aroutio/prop-hop-project/CAD/Test Stand V2.1/Test Stand Assembly.SLDASM

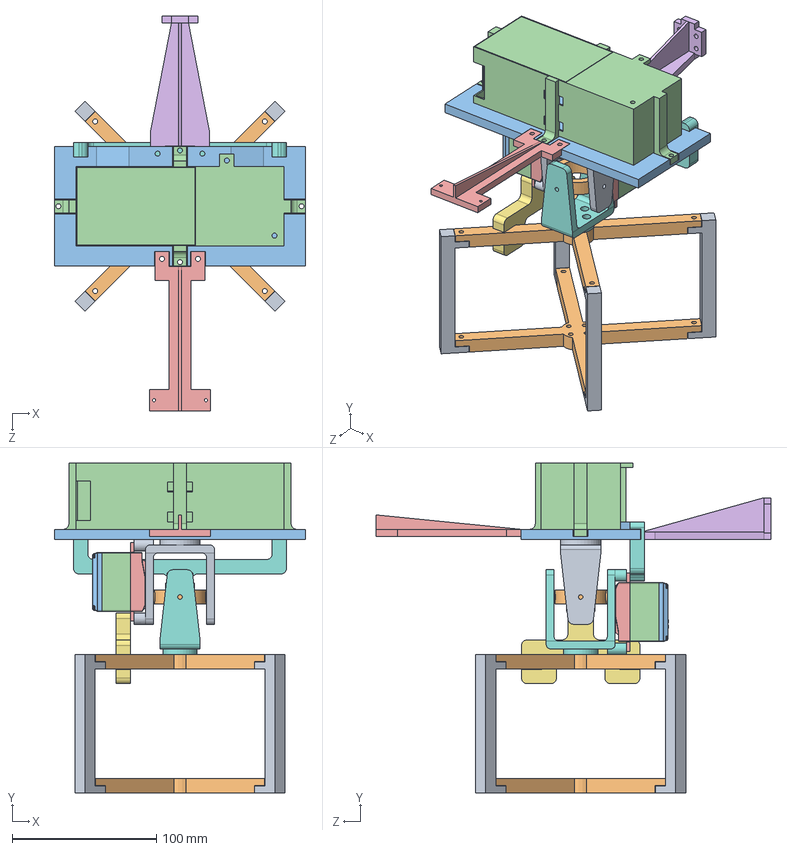
[picture p1: CAD file, 2025-03-03]
CAD/Test Stand V2.1/Test Stand Assembly.SLDASM
174.2 x 228.9 x 274.0 mm
Gimbal Mount Upper
Gimbal Ring
Tap 01 x 2
Tap 02 x 2
Tap 03 x 2
Eje x 2
pan head cross recess screw_iso x 8
Gimbal Mount Lower
Motor Mount Sides x 4
Motor Mount Upper-Lower x 2
Bottom Deck
Upper Deck
LIDAR Sensor Mount
Slider Mount
Upper Gimbal Lock
Lower Gimbal Lock
