aroutio/prop-hop-project/CAD/Test Stand V2.1/Gimbal Sub-Assembly.SLDASM

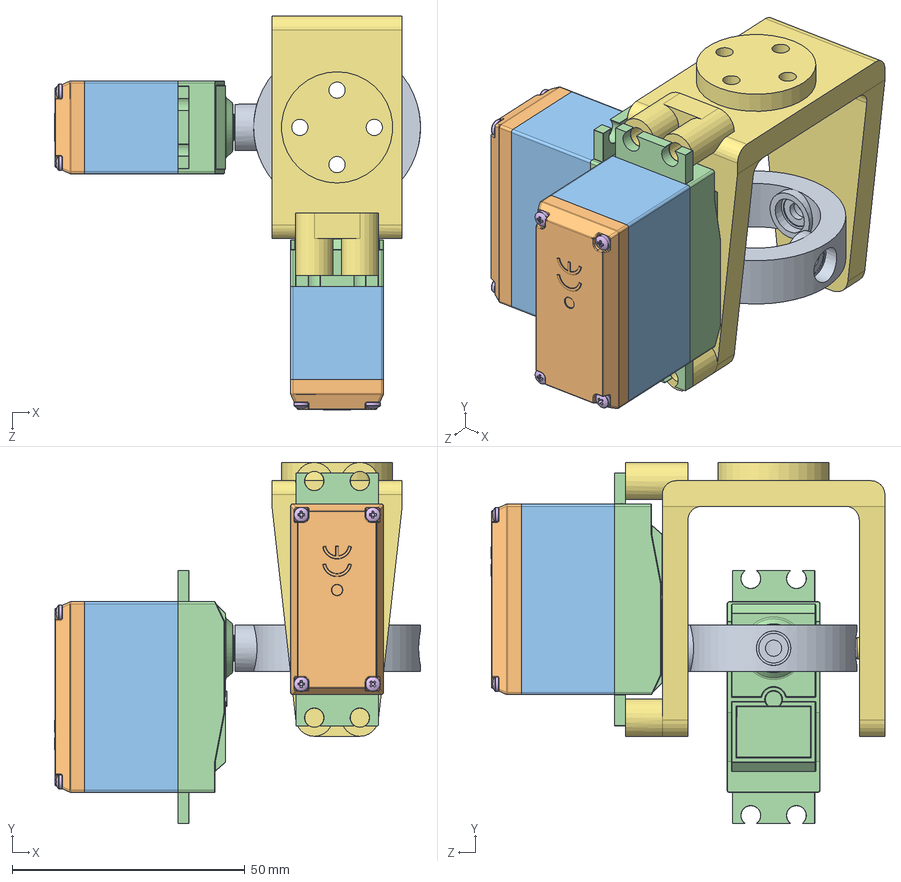
[picture p2: CAD file, 2025-02-25]
CAD/Test Stand V2.1/Gimbal Sub-Assembly.SLDASM
78.7 x 77.6 x 84.7 mm
Gimbal Ring
Tap 01 x 2
Tap 02 x 2
Tap 03 x 2
Eje x 2
pan head cross recess screw_iso x 8
Gimbal Mount Lower
