aroutio/prop-hop-project/CAD/Test Stand V2.1/Bottom Deck.SLDPRT

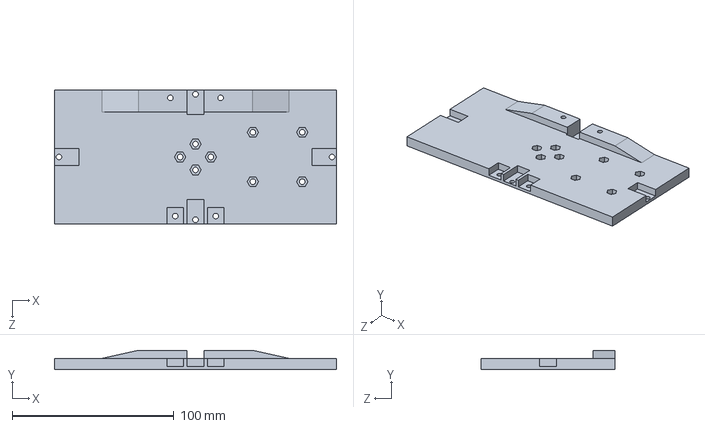
[picture p3: CAD file, 2025-03-03]
CAD/Test Stand V2.1/Bottom Deck.SLDPRT
174.2 x 12.0 x 83.0 mm
