aroutio/prop-hop-project/CAD/Test Stand V2.1/Upper Deck.sldprt

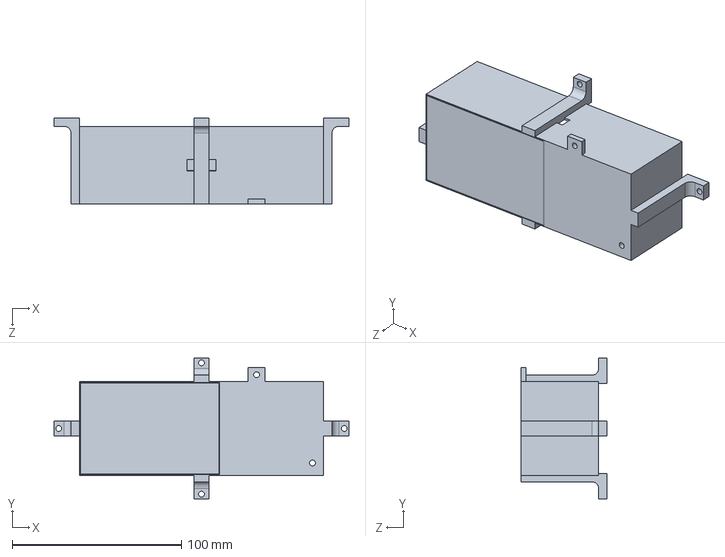
[picture p4: CAD file, 2025-03-03]
CAD/Test Stand V2.1/Upper Deck.sldprt
174.2 x 83.0 x 51.0 mm
