aroutio/prop-hop-project/CAD/Test Stand V2.1/Gimbal Ring.SLDPRT

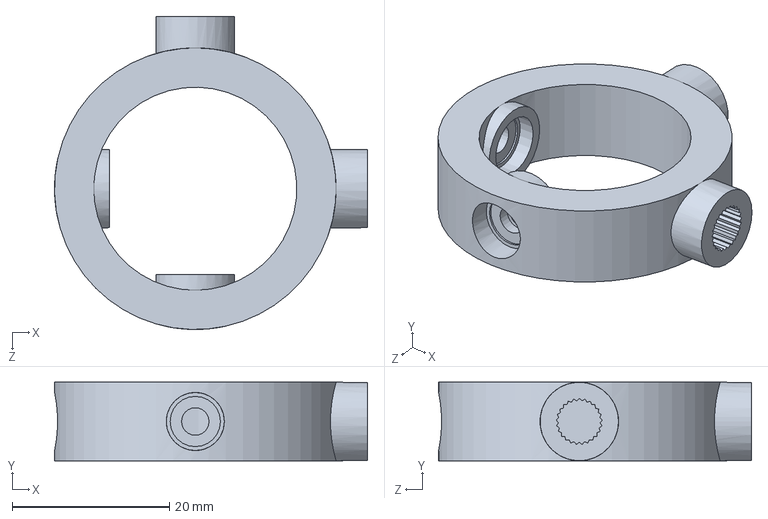
[picture p5: CAD file, 2025-02-25]
CAD/Test Stand V2.1/Gimbal Ring.SLDPRT
39.9 x 10.0 x 39.9 mm
