aroutio/prop-hop-project/CAD/Test Stand V2.1/Lower Gimbal Lock.SLDPRT

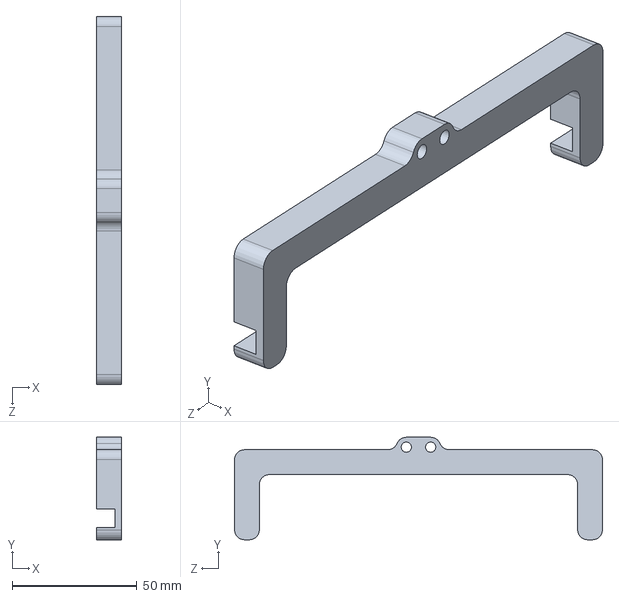
[picture p6: CAD file, 2025-02-25]
CAD/Test Stand V2.1/Lower Gimbal Lock.SLDPRT
10.0 x 41.2 x 147.8 mm
