aroutio/prop-hop-project/(list of files, cad)

Other CAD files:
CAD/Test Stand V2.1/Bottom Deck.STL
CAD/Test Stand V2.1/Gimbal Ring.STL
CAD/Test Stand V2.1/Lower Gimbal Lock.STL
CAD/Test Stand V2.1/Upper Deck.STL
