aroutio/prop-hop-project/CAD/Test Stand V2.1/vehicle_weight V2.xlsx

Cura Weight |  | Scale |  | Version 1.1
Component | Weight [g] | Component | Weight [g] | Structure | Weight [g] |  | Electronics | Weight [g]
Test Frame | 88 | Battery | 210 | Dist Sense Mount | 5 |  | Battery | 210
Second Frame | 27 | Dist Sense Mount | 5 | Test Frame | 76 |  | Dist Sense | 2
Landing Gear (2X) | 16 | Dist Sense | 2 | Second Frame | 26 |  | Prop and Motor | 68
Motor Mount | 4 | Prop and Motor | 68 | Slider | 105 |  | ESC | 31
Slider Mount (L) | 13 | Test Frame | 76 | Slider Mount (L) | 9 |  | Flight Computer | 22
Slider Mount (RR) | 13 | ESC | 31 | Slider Mount (RR) | 9 |  | Power Module | 25
Sense Mount | 5 | Flight Computer | 22 | Motor Mount | 61 |  | Wires | 10
Slider (3D Printed) | 20 | Power Module | 25 | Hardware (fastners) | 60 |  | Bread Board | 76
 |  | Wires | 8 |  |  |  | Y Power Connector | 31
Total | 186 | Hardware (fastners) | 60 | Total | 351 |  | Prop and Motor | 69
 |  | Second Frame | 26 |  |  |  | ESC | 31
 |  | Bread Board | 76 |  |  |  | Telemtry | 12
 |  | Slider | 105
 |  | Slider Mount (L) | 9
 |  | Slider Mount (RR) | 9 |  |  |  | Total | 587
 |  | Y Power Connector | 31
 |  | Prop and Motor | 69 | Total Total | 938
 |  | ESC | 31
 |  | Motor Mount | 61 | Version 2 Estimate
 |  |  |  | Structure | Weight [g] |  | Electronics | Weight [g]
 |  | Accel/Gyro | 3 | Dist Sense Mount | 5 |  | Battery | 210
 |  | Motor Mount | 4 | Test Frame | 76 |  | Dist Sense | 2
 |  | Landing Gear 1 | 8 | Second Frame | 26 |  | Prop and Motor | 68
 |  | Landing Gear 2 | 8 | ~~Slider ~~ | 0 |  | ESC | 31
 |  |  |  | ~~Slider Mount (L)~~ | 0 |  | Flight Computer | 22
 |  | Total | 924 | ~~Slider Mount (RR)~~ | 0 |  | Power Module | 25
 |  |  |  | Motor Mount | 61 |  | Wires | 10
 |  | Recorded |  | Hardware (fastners) | 60 |  | Bread Board | 38
 |  |  |  |  |  |  | Y Power Connector | 31
 |  |  |  | Total | 228 |  | Prop and Motor | 69
 |  | Updated Slider | 11 |  |  |  | ESC | 31
 |  | Each Wheel Assembly | 19 |  |  |  | Telemtry | 16
 |  |  |  |  |  |  | Servos | 78
 |  | New Slider Total | 68 |  |  |  | Accel/Gyro | 3
 |  |  |  |  |  |  | Total | 634
 |  |  |  | Total Total | 862
 |  |  |  | Version 2 (Hover Testing Config)
 |  |  |  | Structure | Weight [g] |  | Electronics | Weight [g]
 |  |  |  | LIDAR Sense Mount | 8 |  | Gimbal Servo 2x | 90
 |  |  |  | Bottom Deck | 36 |  | Battery | 210
 |  |  |  | Upper Deck | 23 |  | Lidar Sensor | 5
 |  |  |  | Motor Mount Upper/Lower 2x | 30 |  | Prop and Motor 2x | 136
 |  |  |  | Motor Mount Sides 2x | 14 |  | ESC 2x | 62
 |  |  |  | Gimble Mount 2x | 30 |  | Flight Computer | 22
 |  |  |  | Gimbal Ring | 4 |  | Power Module | 25
 |  |  |  | Gimbal Bearings 4x | 1 |  | Bread Board | 38
 |  |  |  | Slider Mount | 13 |  | Y Power Connector | 31
 |  |  |  | Slide | 16 |  | Radio | 12
 |  |  |  | Fasteners/Washers/Nuts | 41 |  | IMU | 3
 |  |  |  |  |  |  | Wires | 11
 |  |  |  | Total | 216
 |  |  |  |  |  |  | Total | 645
 |  |  |  | Total Vehicle | 861
 |  |  |  | Version 2 (Flight Config)
 |  |  |  | Structure | Weight [g] |  | Electronics | Weight [g]
 |  |  |  | LIDAR Sense Mount | 8 |  | Gimbal Servo 2x | 90
 |  |  |  | Bottom Deck | 36 |  | Battery | 210
 |  |  |  | Upper Deck | 23 |  | Lidar Sensor | 5
 |  |  |  | Motor Mount Upper/Lower 2x | 30 |  | Prop and Motor 2x | 136
 |  |  |  | Motor Mount Sides 2x | 14 |  | ESC 2x | 62
 |  |  |  | Gimble Mount 2x | 30 |  | Flight Computer | 22
 |  |  |  | Gimbal Ring | 4 |  | Power Module | 25
 |  |  |  | Gimbal Bearings 4x | 1 |  | Bread Board | 38
 |  |  |  | ~~Slider Mount~~ | 0 |  | Y Power Connector | 31
 |  |  |  | ~~Slide~~ | 0 |  | Radio | 12
 |  |  |  | Fasteners/Washers/Nuts | 38 |  | IMU | 3
 |  |  |  |  |  |  | Wires | 11
 |  |  |  | Total | 184
 |  |  |  |  |  |  | Total | 645
 |  |  |  | Total Vehicle | 829
 |  |  |  | Version 2.1 Estimate (Hover Testing Config)
 |  |  |  | Structure | Weight [g] |  | Electronics | Weight [g]
 |  |  |  | LIDAR Sense Mount | 8 |  | Gimbal Servo 2x | 90
 |  |  |  | Bottom Deck | 40 |  | Battery | 403
 |  |  |  | Upper Deck | 26 |  | Lidar Sensor | 5
 |  |  |  | Motor Mount Upper/Lower 2x | 34 |  | Prop and Motor 2x | 96
 |  |  |  | Motor Mount Sides 4x | 20 |  | ESC | 19
 |  |  |  | Gimble Mount 2x | 30 |  | Flight Computer | 22
 |  |  |  | Gimbal Ring | 4 |  | Power Module | 22
 |  |  |  | Gimbal Bearings 4x | 1 |  | Bread Board | 38
 |  |  |  | Slider Mount | 12 |  | ~~Y Power Connector~~ | 0
 |  |  |  | Slide | 16 |  | Radio | 12
 |  |  |  | Fasteners/Washers/Nuts | 42 | Needs Updating | IMU+MAG+Wires | 7
 |  |  |  |  |  |  | GPS | 8
 |  |  |  | Total | 233 |  | PWM Board | 9
 |  |  |  |  |  |  | Wires | 11 | Needs Updating
 |  |  |  |  |  |  | Total | 742
 |  |  |  | Total Vehicle | 975
 |  |  |  | Version 2.1 Estimate (Flight Config)
 |  |  |  | Structure | Weight [g] |  | Electronics | Weight [g]
 |  |  |  | LIDAR Sense Mount | 8 |  | Gimbal Servo 2x | 90
 |  |  |  | Bottom Deck | 40 |  | Battery | 403
 |  |  |  | Upper Deck | 26 |  | Lidar Sensor | 5
 |  |  |  | Motor Mount Upper/Lower 2x | 34 |  | Prop and Motor 2x | 94
 |  |  |  | Motor Mount Sides 2x | 20 |  | ESC | 19
 |  |  |  | Gimble Mount 2x | 30 |  | Flight Computer | 22
 |  |  |  | Gimbal Ring | 4 |  | Power Module | 22
 |  |  |  | Gimbal Bearings 4x | 1 |  | Bread Board | 38
 |  |  |  | ~~Slider Mount~~ | 0 |  | ~~Y Power Connector~~ | 0
 |  |  |  | ~~Slide~~ | 0 |  | Radio | 12
 |  |  |  | Fasteners/Washers/Nuts | 38 | Needs Updating | IMU+MAG+Wires | 7
 |  |  |  |  |  |  | GPS | 8
 |  |  |  | Total | 201 |  | PWM Board | 9
 |  |  |  |  |  |  | Wires | 11 | Needs Updating
 |  |  |  |  |  |  | Total | 740
 |  |  |  | Total Vehicle | 941
 |  |  |  | Version 2.1 Estimate (Hover Testing Config, POST CRASH UPDATES)
 |  |  |  | Structure | Weight [g] |  | Electronics | Weight [g]
 |  |  |  | LIDAR Sense Mount | 8 |  | Gimbal Servo 2x | 90
 |  |  |  | Bottom Deck (Updated) | 42 |  | Battery | 403
 |  |  |  | Upper Deck (Updated) | 53 |  | Lidar Sensor | 5
 |  |  |  | Motor Mount Upper/Lower 2x | 34 |  | Prop and Motor 2x | 96
 |  |  |  | Motor Mount Sides 4x | 20 |  | ESC | 19
 |  |  |  | Gimble Mount 2x | 30 |  | Flight Computer | 22
 |  |  |  | Gimbal Ring (Updated) | 4 |  | Power Module | 22
 |  |  |  | Gimbal Bearings 4x | 1 |  | Bread Board | 38
 |  |  |  | Slider Mount | 12 |  | ~~Y Power Connector~~ | 0
 |  |  |  | Slide | 16 |  | Radio | 12
 |  |  |  | Fasteners/Washers/Nuts | 42 | Needs Updating | IMU+MAG+Wires | 7
 |  |  |  |  |  |  | GPS | 8
 |  |  |  | Total | 262 |  | PWM Board | 9
 |  |  |  |  |  |  | Wires | 11 | Needs Updating
 |  |  |  |  |  |  | Total | 742
 |  |  |  | Total Vehicle | 1004
