aroutio/prop-hop-project/(commit log)

2025-02-25 Modified Upper Deck to improve strength and better protect the battery incase of crash.
    [Test Stand Assembly.SLDASM, Upper Deck.sldprt]
2025-02-25 Modified Lower Deck to improve strength where slider mount connects incase of crash.
    [Bottom Deck.SLDPRT, Test Stand Assembly.SLDASM]
2025-02-25 Modified Lower Gimbal Lock to accommodate modified Lower Deck.
    [Lower Gimbal Lock.SLDPRT, Test Stand Assembly.SLDASM]
2025-02-25 Reduced spline gear diameter by 0.1 mm on Gimbal Ring to experiment with tighter fit on servo motor.
    [Gimbal Ring.SLDPRT, Gimbal Sub-Assembly.SLDASM, Test Stand Assembly.SLDASM]
2025-02-25 Modified Upper Deck to accomodate zipties and battery wires
    [Test Stand Assembly.SLDASM, Upper Deck.sldprt]
2025-02-25 Generated STL files to 3D print modified parts, Bottom Deck, Gimbal Ring, Lower Gimbal Lock, and Upper Deck
    [Bottom Deck.STL, Gimbal Ring.STL, Lower Gimbal Lock.STL, Test Stand Assembly.SLDASM, Upper Deck.STL]
2025-02-27 Corrected error on Bottom Deck where the fastner hole did not exist
    [Bottom Deck.SLDPRT, Test Stand Assembly.SLDASM]
2025-02-27 Updated Bottom Deck STL file to reflect previous change
    [Bottom Deck.SLDPRT, Bottom Deck.STL]
2025-03-02 Updated vehicle weight estimates to include updated parts post crash
    [vehicle_weight V2.xlsx]
2025-03-02 Found an error where lower gimbal center value was set the same as upper gimbal center value
    [prop_lander_modeling.ino]
2025-03-02 Found an error in the comments refrencing the use of incorrect function in code
    [gimbal_servo_calibration_V2.ino]
2025-03-03 Modified fastner position to accomodate fillets on mounting features and added material to upperdeck wallsand created corresponding STL files for 3D printing
    [Bottom Deck.SLDPRT, Bottom Deck.STL, Test Stand Assembly.SLDASM, Upper Deck.STL, Upper Deck.sldprt]
